bigjosh/Embedded_Hardware/Diptrace/Programming Jig/images/2017-08-16 23.25.09.jpg

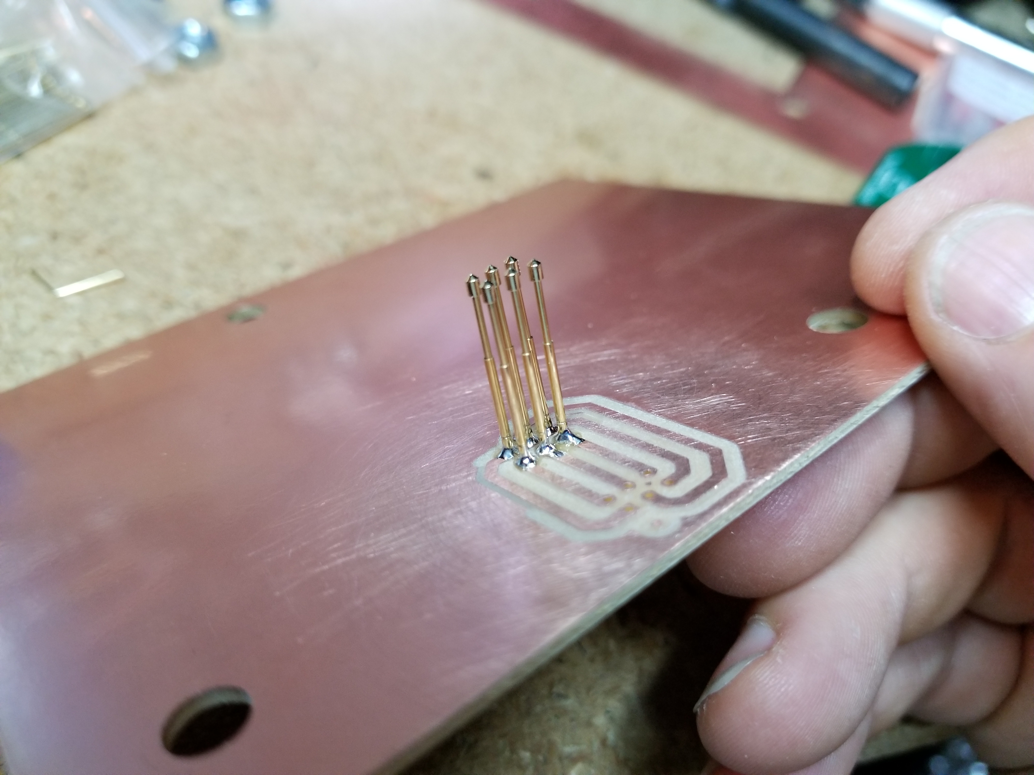
Diptrace/Programming Jig/images/2017-08-16 23.25.09.jpg
