bigjosh/Embedded_Hardware/Diptrace/Programming Jig/images/2017-08-16 23.21.22.jpg

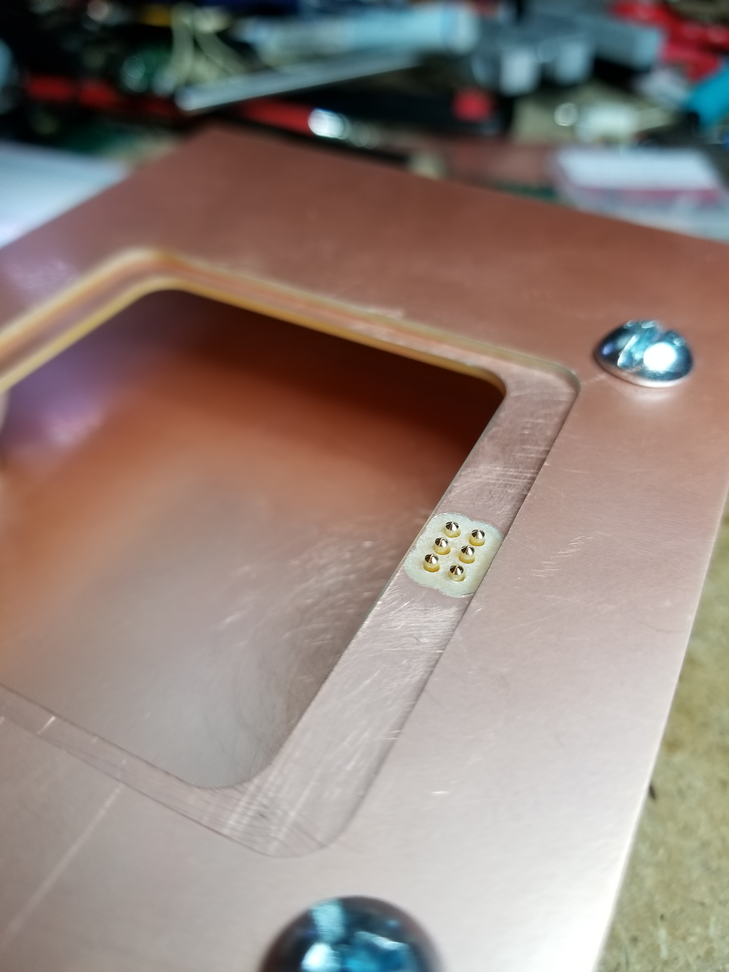
Diptrace/Programming Jig/images/2017-08-16 23.21.22.jpg
