bigjosh/Embedded_Hardware/(list of files, drawings)

Other design files:
Diptrace/Programming Jig/floor.dip
Diptrace/Programming Jig/Mezz-top.dip
Diptrace/Programming Jig/Roof.dip
