bigjosh/Embedded_Hardware/EAGLE_CAD/Test_Fixtures/PR9001.brd

## EAGLE design EAGLE_CAD/Test_Fixtures/PR9001.brd (2017-06-27)

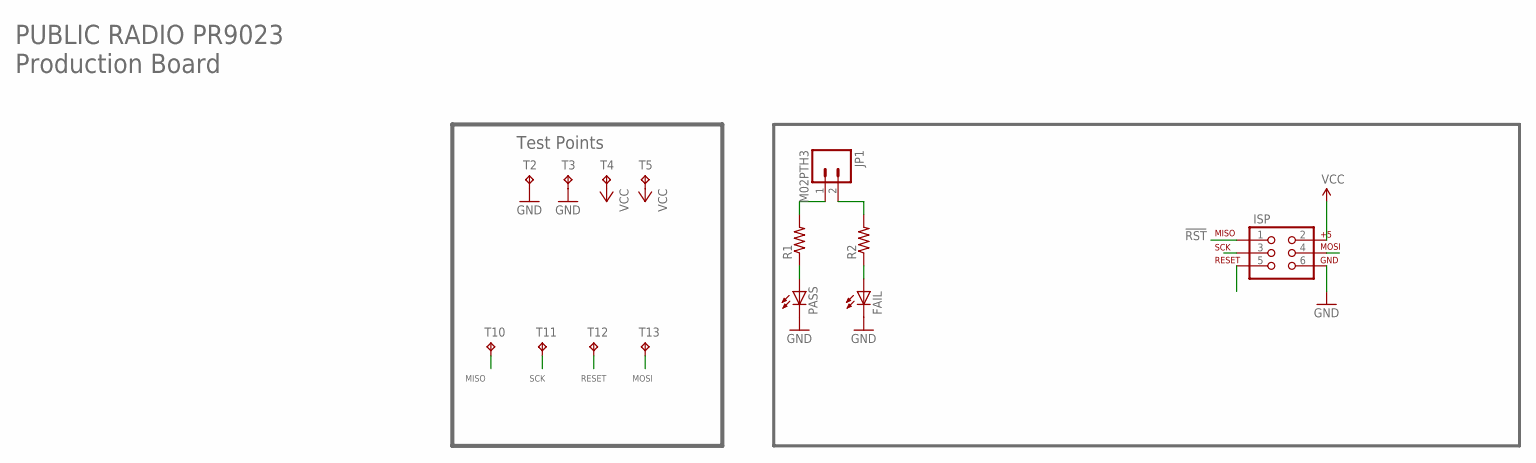
[picture p7: schematic PR9001.sch]

Parts:
FAIL: LED5MM
ISP: AVR_SPI_PRG_6NS; 2X3-NS
JP1: M02PTH3; 1X02_LONGPADS
PASS: LED5MM
R1, R2: RESISTORPTH-1/4W-VERT; AXIAL-0.1
T2, T3, T4, T5, T10, T11, T12, T13: PR9001_TESTPOINT

Connections:
!RST: ISP.1, T10.P$1
GND: FAIL.K (C), ISP.6, PASS.K (C), T2.P$1, T3.P$1
unnamed: JP1.2, R2.P$2 (2)
unnamed: PASS.A, R1.P$1 (1)
unnamed: JP1.1, R1.P$2 (2)
unnamed: FAIL.A, R2.P$1 (1)
RESET: ISP.5, T12.P$1
SCLK: ISP.3, T11.P$1
SDIO: ISP.4, T13.P$1
VCC: ISP.2, T4.P$1, T5.P$1

Notes on the sheet:
PUBLIC RADIO PR9023 Production Board
Test Points
MISO
SCK
RESET
MOSI

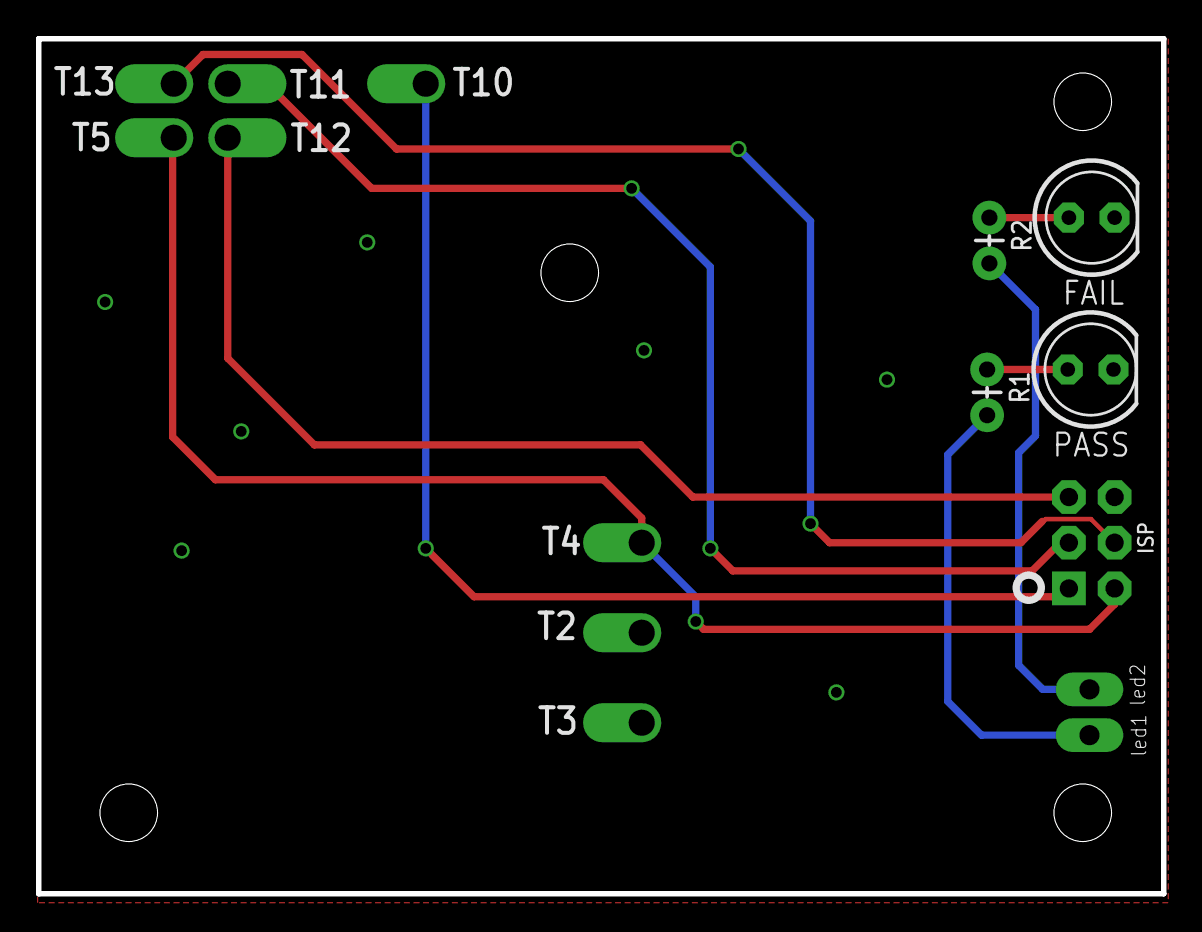
[picture p8: board PR9001.brd from above]

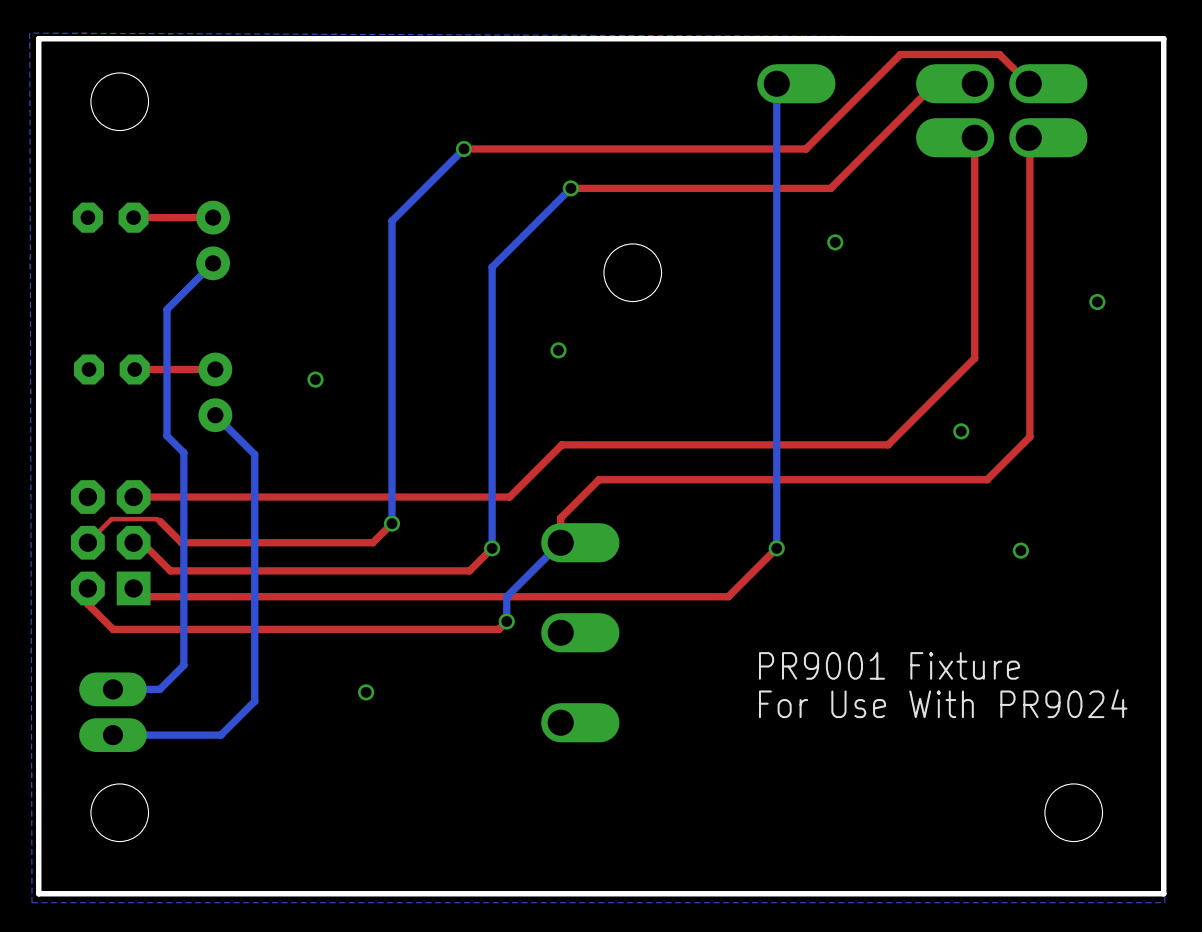
[picture p9: board PR9001.brd from below]

Board: 2 copper layers, 62.5 x 47.5 mm, 14 parts (9 on the bottom side), 10 nets.
