bigjosh/Embedded_Hardware/EAGLE_CAD/PR9025/PR9025.brd

## EAGLE design EAGLE_CAD/PR9025/PR9025.brd (2017-06-27)

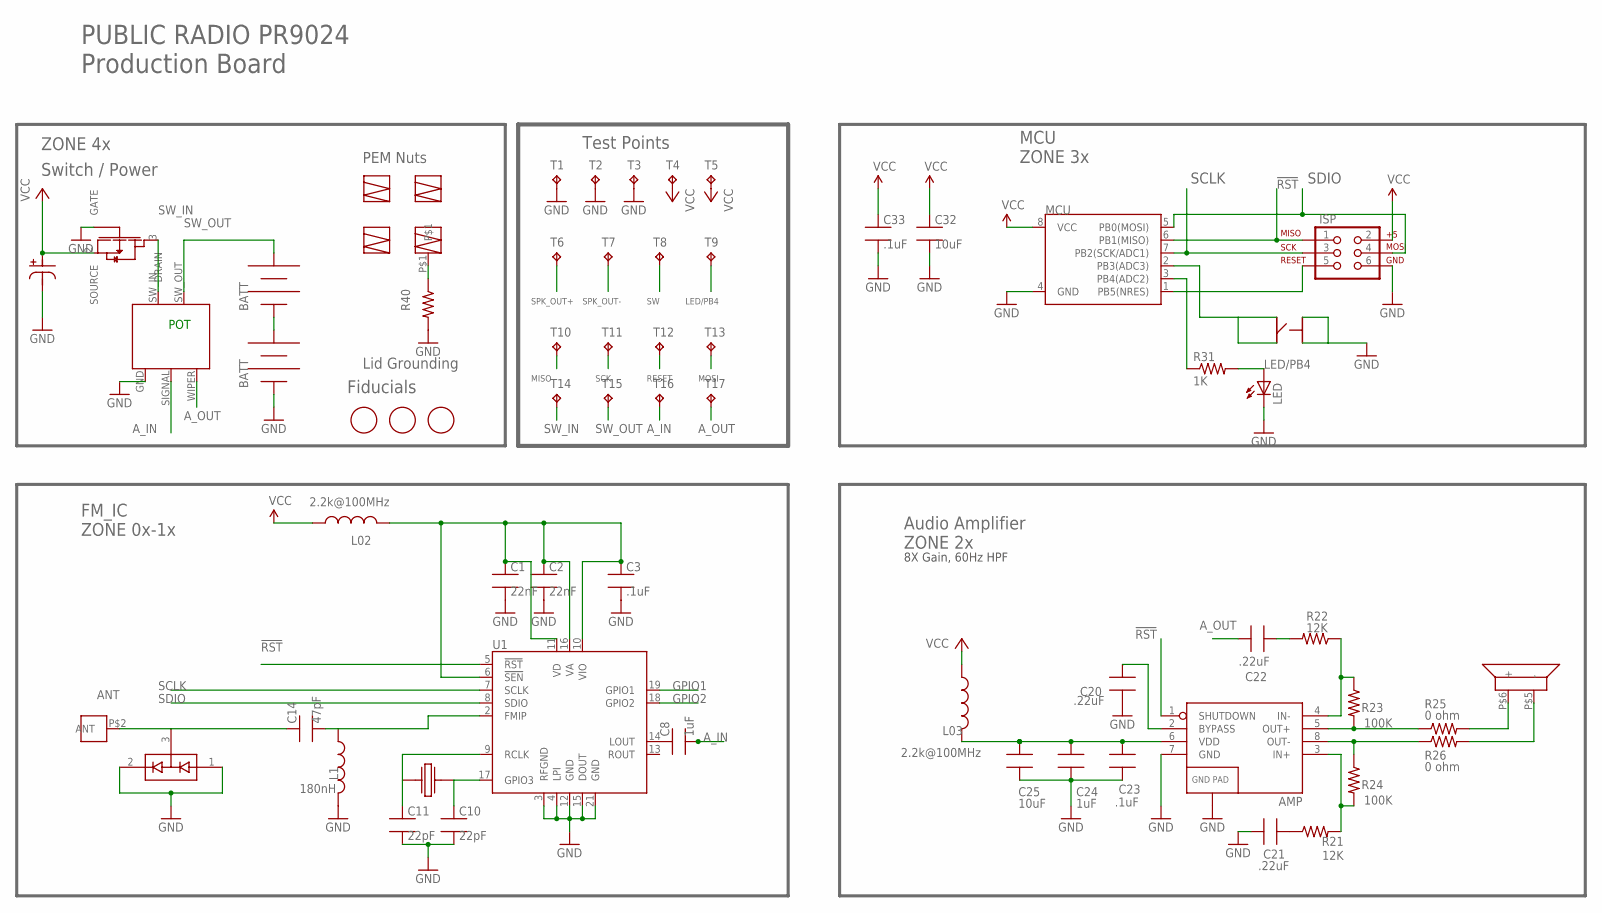
[picture p10: schematic PR9025.sch]

Parts:
AMP: TPA6203A1; 8-MSOP
ANT_MOUNT: DNP; PEM_M3
C1, C2: 22nF; 0603_CPL; VOLTAGE 16V; MFG_PN CL10B223KB8NNNC
C3, C23, C33: .1uF; 0603_CPL; VOLTAGE 16V; MFG_PN CL10B104KB8SFNC
C8, C24: 1uF; 0603_CPL; VOLTAGE 10V; MFG_PN CL10B105KP8NNNC
C10, C11: 22pF; 0603_CPL; VOLTAGE 50V; MFG_PN C1608C0G1H220J080AA
C14: 47pF; 0603_CPL; VOLTAGE 50V; MFG_PN CL10C470JB8NCNC
C20, C21, C22: .22uF; 0603_CPL; VOLTAGE 16V; MFG_PN C1608X7R1C224K080AC
C25, C32: 10uF; 0603_CPL; VOLTAGE 6.3V; MFG_PN CL10A106MQ8NNNC
C40: 220uF; NICHICON_UD_63; VOLTAGE 16V
D1: BAV99; SOT23_CPL; MFG_PN BAV99,215
FET1: AO3435; SOT23_CPL; MFG_PN AO3435
ISP: AVR_SPI_PRG_6NS; 2X3-NS
JP5, JP6: BK-92_MPD_AA_BATT_CLIP; BK92_AA_BATT; MFG_PN 2 of BK92 - supplied by CL Labs
L1: 180nH; 0805_ADAFRUIT; MFG_PN AISC-0805-R18J-T
L02, L03: 2.2k@100MHz; 0603_CPL; MFG_PN HZ0603A222R-10
LED: HSMC-C265_REVERSE_MOUNT_LED; HSMC-C265_REVERSE_MOUN_LED; MFG_PN HSMC-C265
MARK1, MARK2, MARK3: FIDUCIAL; FIDUCIAL_1MM
MCU: ATTINY45TINY45-20-SMT; 8-SOIC
R1: VOLUME_POT; H17112NS_A10K_L20F-002
R21, R22: 12K; 0603_CPL; MFG_PN RC0603FR-0712KL
R23, R24: 100K; 0603_CPL; MFG_PN ERJ-3EKF1003V
R25, R26: 0 ohm; 0805_ADAFRUIT; MFG_PN ERJ-6GEY0R00V
R31: 1K; 0603_CPL; MFG_PN 311-1.00KHRCT-ND
R40: DNP; 0603_CPL; MFG_PN ERJ-3GEY0R00V
SPKR_PLACE: DNP; PR2024_SPKR_PLACE(SMD)
SW1: C&K_PTS645; C&K_PTS645_SMT
T1, T2, T3, T4, T5, T6, T7, T8, T9, T10, T11, T12, T13, T14, T15, T16, T17: TPTP20R; TP20R
U1: SI4702-C19-GMR; SI470X_20_QFN; MFG_PN Si4702 C19 GM - supplied by CL Labs
U$2, U$3, U$4: PEM_SMT
U$5: PEM_M3_SMT_W/PIN; PEM_SMT
X1: ABS25XTAL; 4-SOJ

Connections:
3.3V: C1.1, C2.1, C3.1, L02.2, U1.6 (!SEN), U1.10 (VIO), U1.11 (VD), U1.16 (VA)
!RST: AMP.1 (SHUTDOWN), ISP.1, MCU.6 (PB1(MISO)), T10.TP, U1.5 (!RST)
ANT: ANT_MOUNT.P$2, C14.1, D1.3 (COM)
A_IN: C8.2, R1.SIGNAL, T16.TP
A_OUT: C22.2, R1.WIPER, T17.TP
GND: AMP.7 (GND), AMP.9 (GND), C1.2, C2.2, C3.2, C10.2, C11.2, C20.1, C21.1, C23.2, C24.2, C25.2, C32.2, C33.2, C40.P$2, D1.1 (A1), D1.2 (C2), FET1.1 (GATE), ISP.6, JP6.NEG, JP6.NEG@2 (NEG), L1.2, LED.P$2 (C), MCU.4 (GND), R1.GND, R40.2, SW1.P$1, SW1.P$2, T1.TP, T2.TP, T3.TP, U1.3 (RFGND), U1.4 (LPI), U1.12 (GND), U1.15 (DOUT), U1.21 (GND)
GPIO1: U1.19 (GPIO1)
GPIO2: U1.18 (GPIO2)
LED/PB4: MCU.3 (PB4(ADC2)), R31.1, T9.TP
unnamed: C11.1, U1.9 (RCLK), X1.P$1
unnamed: AMP.6 (VDD), C23.1, C24.1, C25.1, L03.2
unnamed: C22.1, R22.2
unnamed: AMP.5 (OUT+), R23.2, R25.1
unnamed: AMP.3 (IN+), R21.2, R24.2
unnamed: R40.1, U$5.P$1
unnamed: LED.P$1 (A), R31.2
unnamed: C8.1, U1.14 (LOUT)
unnamed: C10.1, U1.17 (GPIO3), X1.P$4
unnamed: AMP.8 (OUT-), R24.1, R26.1
unnamed: AMP.2 (BYPASS), C20.2
unnamed: JP5.NEG, JP5.NEG@2 (NEG), JP6.POS, JP6.POS@2 (POS)
unnamed: AMP.4 (IN-), R22.1, R23.1
unnamed: C14.2, L1.1, U1.2 (FMIP)
unnamed: C21.2, R21.1
RESET: ISP.5, MCU.1 (PB5(NRES)), T12.TP
SCLK: ISP.3, MCU.7 (PB2(SCK/ADC1)), T11.TP, U1.7 (SCLK)
SDIO: ISP.4, MCU.5 (PB0(MOSI)), T13.TP, U1.8 (SDIO)
SPK_OUT+: R25.2, SPKR_PLACE.P$6 (+), T6.TP
SPK_OUT-: R26.2, SPKR_PLACE.P$5 (-), T7.TP
SW: MCU.2 (PB3(ADC3)), SW1.P$3, SW1.P$4, T8.TP
SW_IN: FET1.3 (DRAIN), R1.SW_IN, T14.TP
SW_OUT: JP5.POS, JP5.POS@2 (POS), R1.SW_OUT, T15.TP
VCC: C32.1, C33.1, C40.P$1, FET1.2 (SOURCE), ISP.2, L02.1, L03.1, MCU.8 (VCC), T4.TP, T5.TP

Notes on the sheet:
POT
FM_IC ZONE 0x-1x
Switch / Power
Lid Grounding
Audio Amplifier ZONE 2x
MCU ZONE 3x
PUBLIC RADIO PR9024 Production Board
Fiducials
Test Points
MISO
SCK
RESET
MOSI
8X Gain, 60Hz HPF
ZONE 4x
PEM Nuts

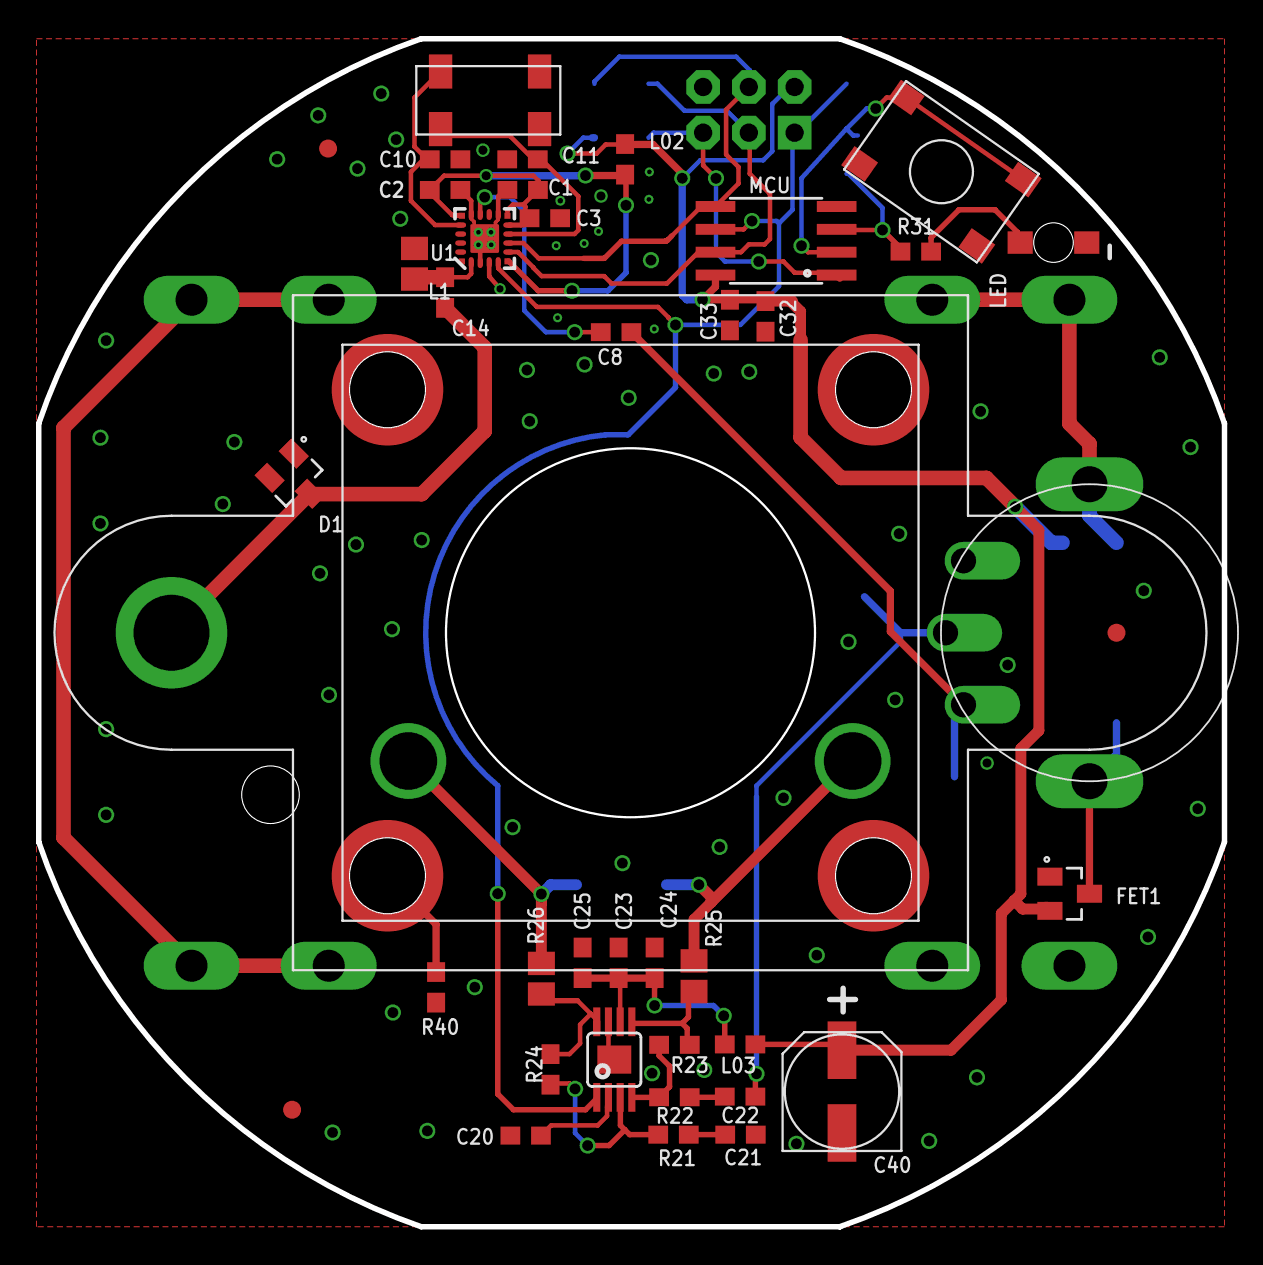
[picture p11: board PR9025.brd from above]

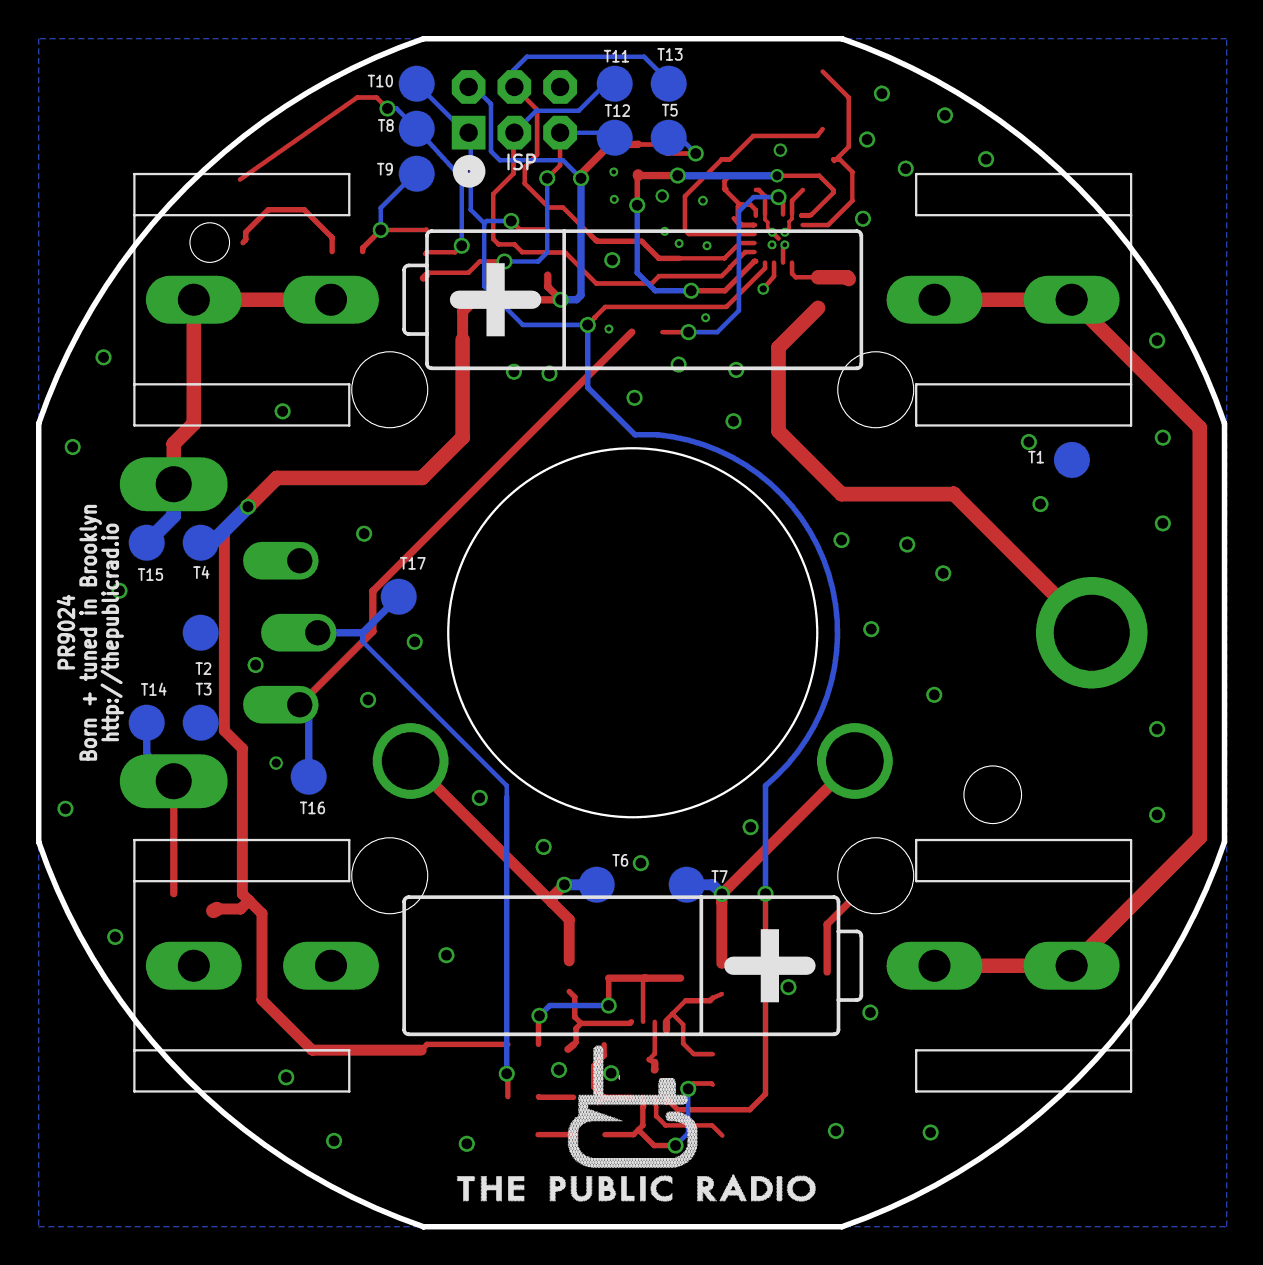
[picture p12: board PR9025.brd from below]

Board: 2 copper layers, 65.9 x 66.0 mm, 66 parts (21 on the bottom side), 31 nets.

Other parts of the board:
U$1: PR_LOGO
