bigjosh/Embedded_Hardware/(threads)

Thread 1 (2017-05-22):

R30 pull-up on ATTINY ~RESET can be safely ommited

bigjosh, 2017-05-22:
ATTINY has built in pull-up, this resistor is redundant.

8.1...

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
