bigjosh/Embedded_Hardware/(commit log)

2017-08-17 Roof tight fit, needed sanding. Maybe pull back a mil next time?
    [Mezz-top.dip, Roof.dip, floor.dip]
2017-08-17 Added dimensions to roof
    [Roof.dip]
2017-08-17 Mezz now with rounded corners, 3 holes, left side more clearance for battery clips.
    [Mezz-top.dip]
2017-08-17 Pogo pins holes too tight - manually opened them with a 1mm drill bit.
    [floor.dip]
2017-08-17 Better dimensioning on top
    [Roof.dip]
2017-09-20 Revised floor to add power connector and move ISP header to side
    [floor.dip]
